samartzidis/NoiaBot/docs/20260201205910.png

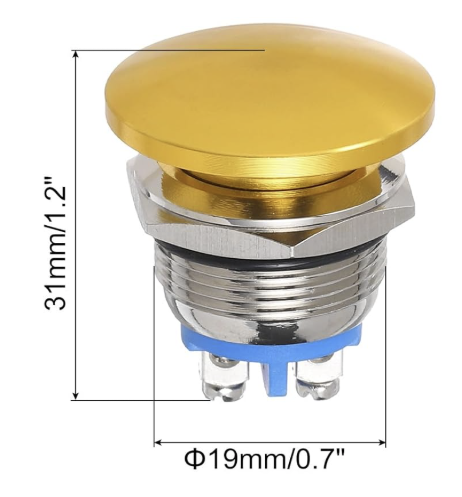
docs/20260201205910.png
