samartzidis/NoiaBot/models/s330-speakerphone-attachment.stl

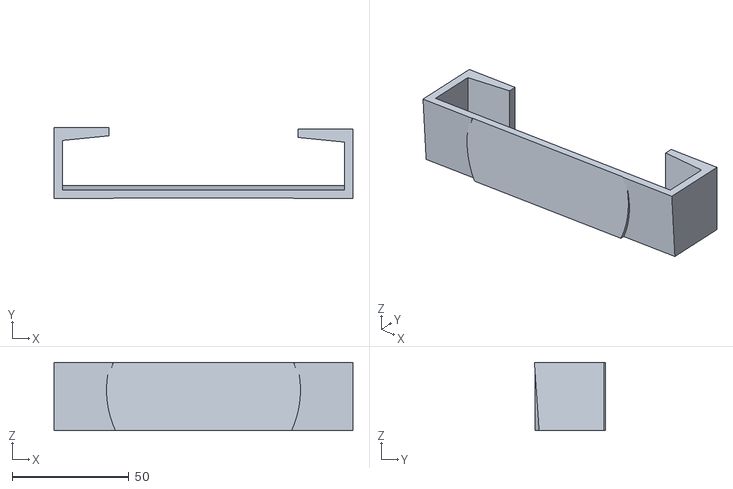
[picture p9: CAD file, 2026-02-03]
models/s330-speakerphone-attachment.stl
128.0 x 30.5 x 29.1
