samartzidis/NoiaBot/models/body.stl

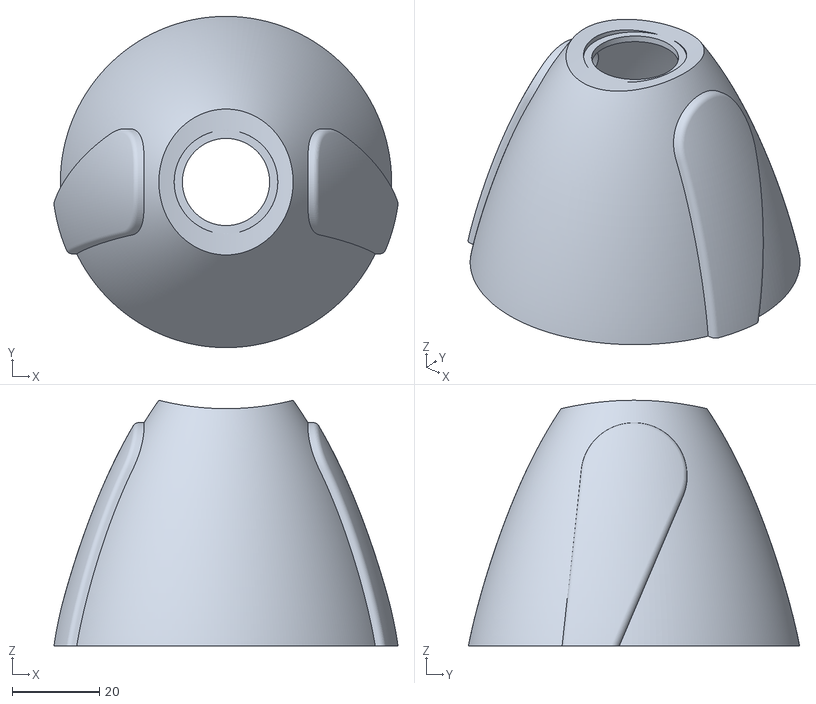
[picture p10: CAD file, 2026-02-03]
models/body.stl
79.0 x 76.0 x 56.4
