samartzidis/NoiaBot/models/head-bottom.stl

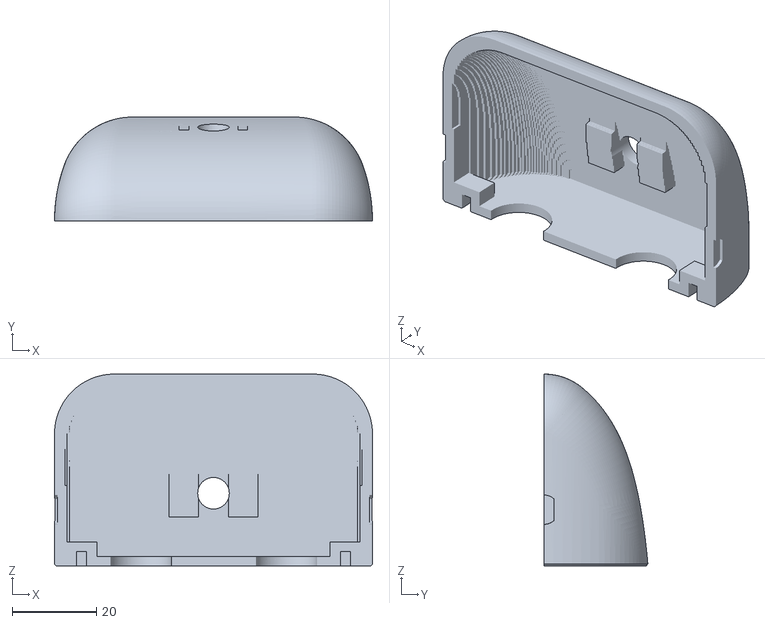
[picture p11: CAD file, 2026-02-03]
models/head-bottom.stl
75.6 x 24.7 x 45.6
