samartzidis/NoiaBot/models/S330-attachment-draft.3mf

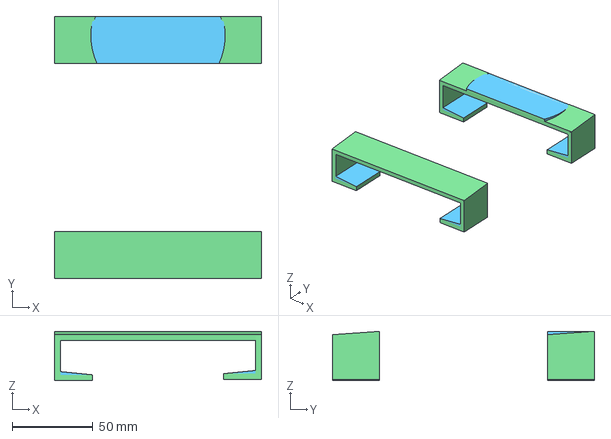
[picture p12: CAD file, 2026-02-03]
models/S330-attachment-draft.3mf
128.0 x 162.1 x 30.5 mm
