samartzidis/NoiaBot/models/eyes.stl

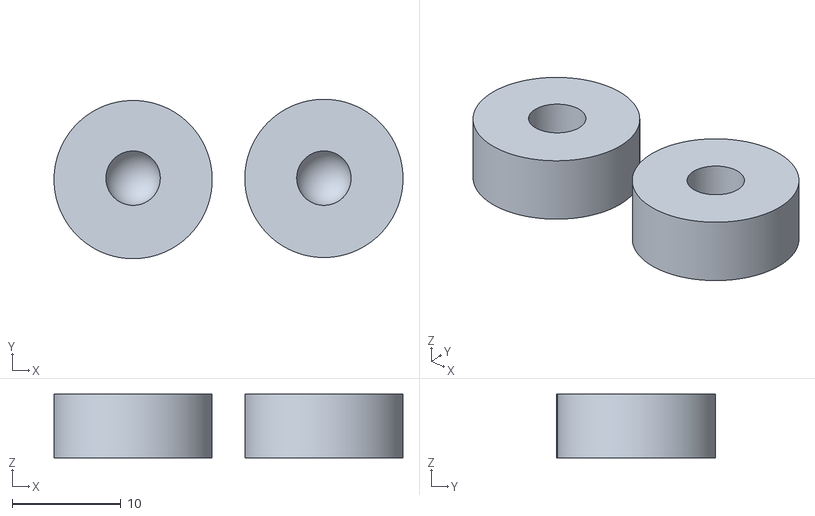
[picture p13: CAD file, 2026-02-03]
models/eyes.stl
32.1 x 14.6 x 5.88
