samartzidis/NoiaBot/models/face.stl

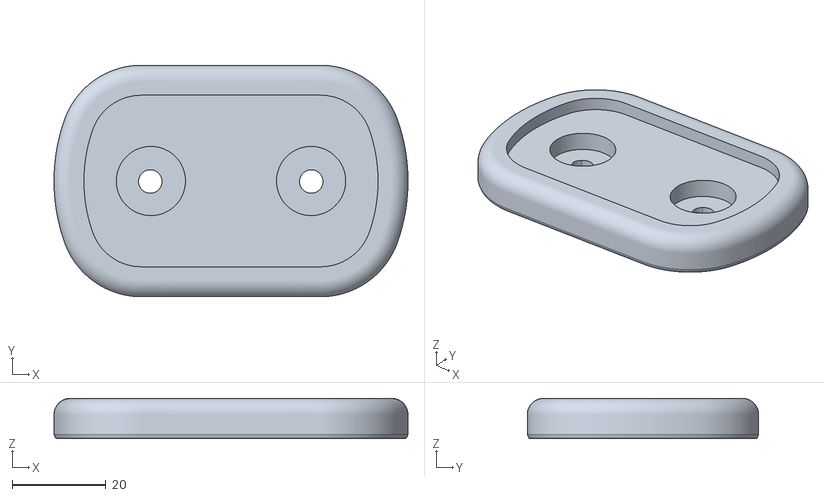
[picture p14: CAD file, 2026-02-03]
models/face.stl
75.6 x 49.4 x 8.61
