samartzidis/NoiaBot/models/ear-bits.stl

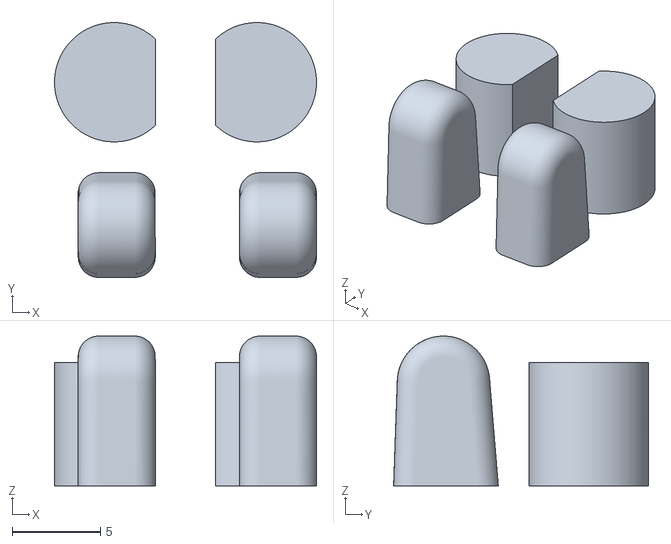
[picture p15: CAD file, 2026-02-03]
models/ear-bits.stl
14.8 x 14.4 x 8.47
