samartzidis/NoiaBot/models/head-top.stl

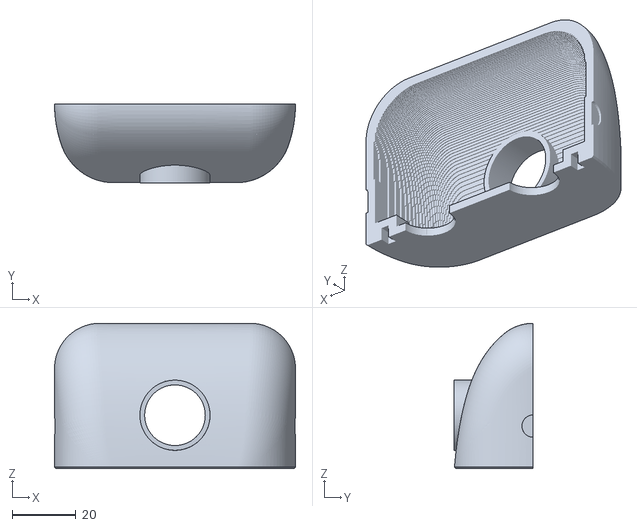
[picture p16: CAD file, 2026-02-03]
models/head-top.stl
75.6 x 24.8 x 45.6
