samartzidis/NoiaBot/models/ears.stl

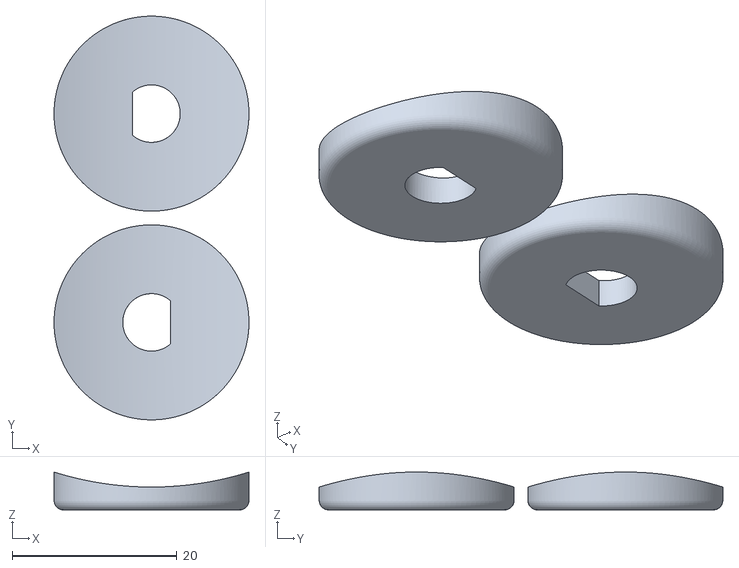
[picture p17: CAD file, 2026-02-03]
models/ears.stl
23.7 x 49.0 x 4.61
