samartzidis/NoiaBot/models/antennas.stl

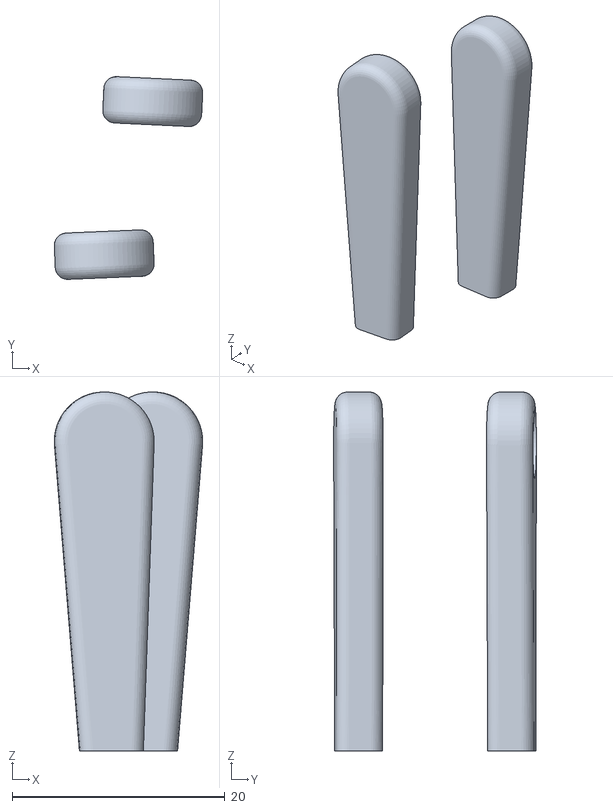
[picture p18: CAD file, 2026-02-03]
models/antennas.stl
13.9 x 19.1 x 33.7
