samartzidis/NoiaBot/models/base.stl

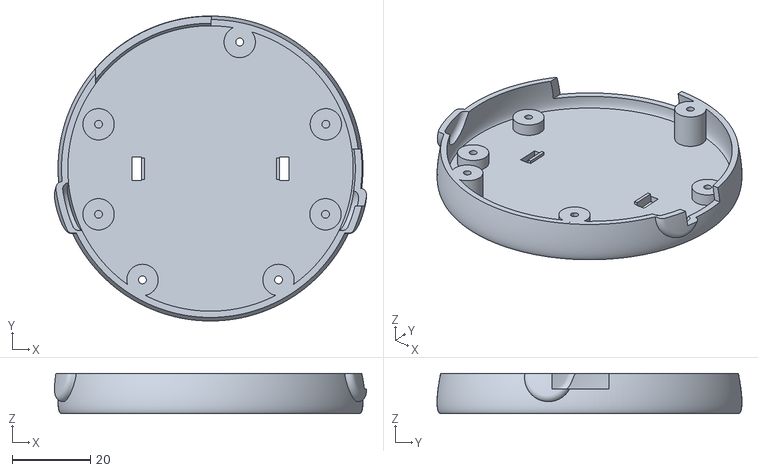
[picture p19: CAD file, 2026-02-03]
models/base.stl
79.7 x 77.9 x 10.3
