samartzidis/NoiaBot/models/neck.stl

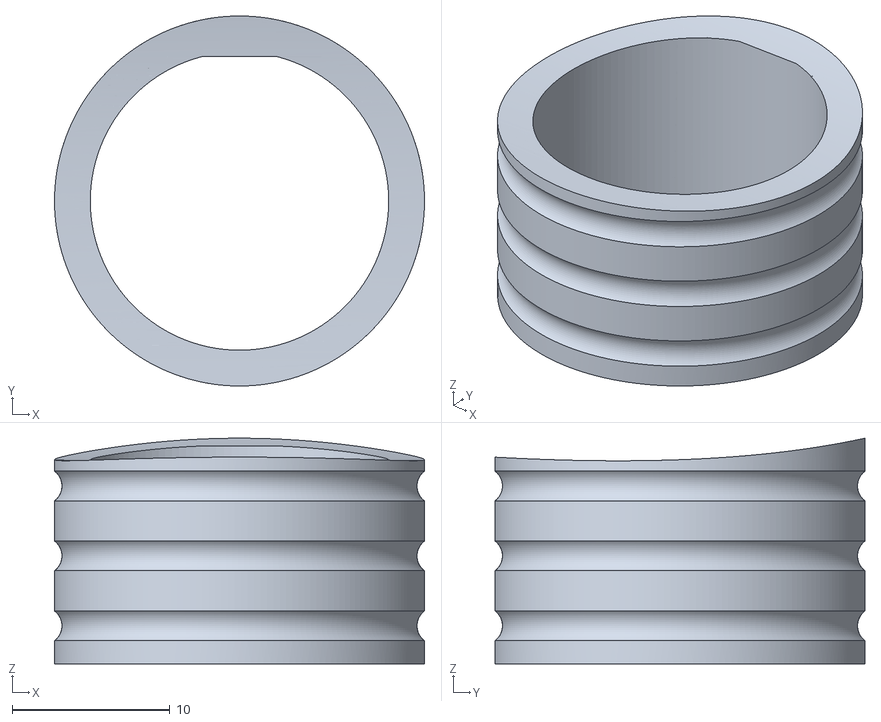
[picture p20: CAD file, 2026-02-03]
models/neck.stl
23.4 x 23.4 x 14.3
